zhhh0591/clawd-lcd-enclosure/docs/sheet2.png

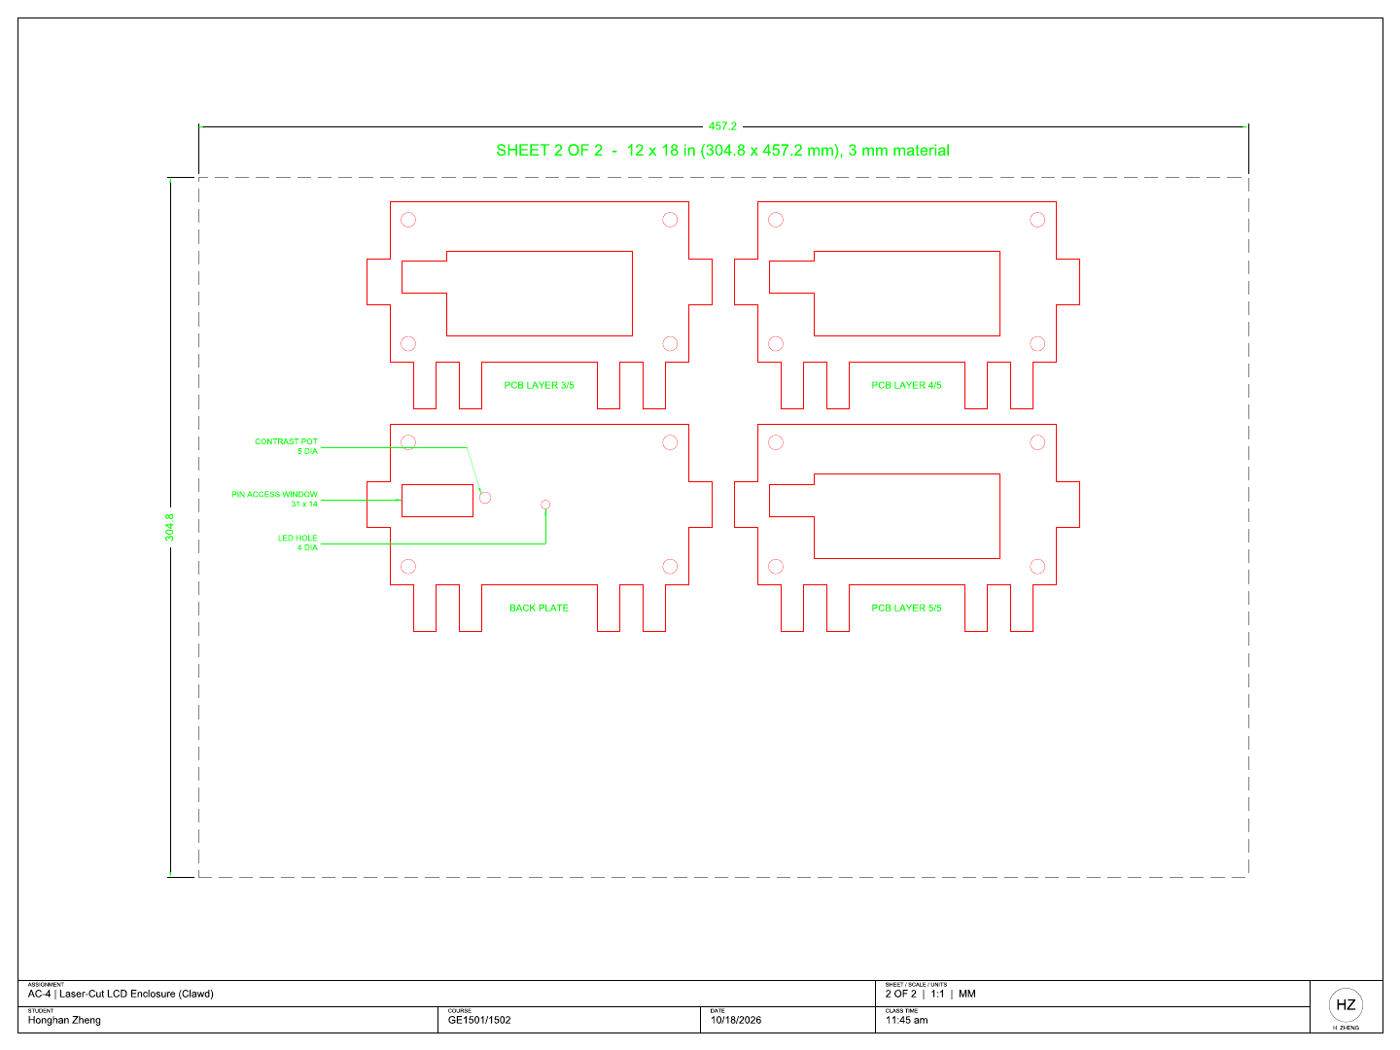
docs/sheet2.png
