zhhh0591/clawd-lcd-enclosure/FYELIC/Zheng_AC4_CUT_12x12.dxf

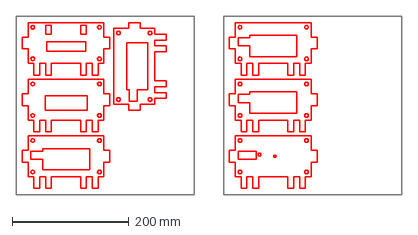
[picture p5: CAD file, 2026-10-19]
FYELIC/Zheng_AC4_CUT_12x12.dxf
659.6 x 304.8 mm
