zhhh0591/clawd-lcd-enclosure/works/Zheng_AC4.dxf

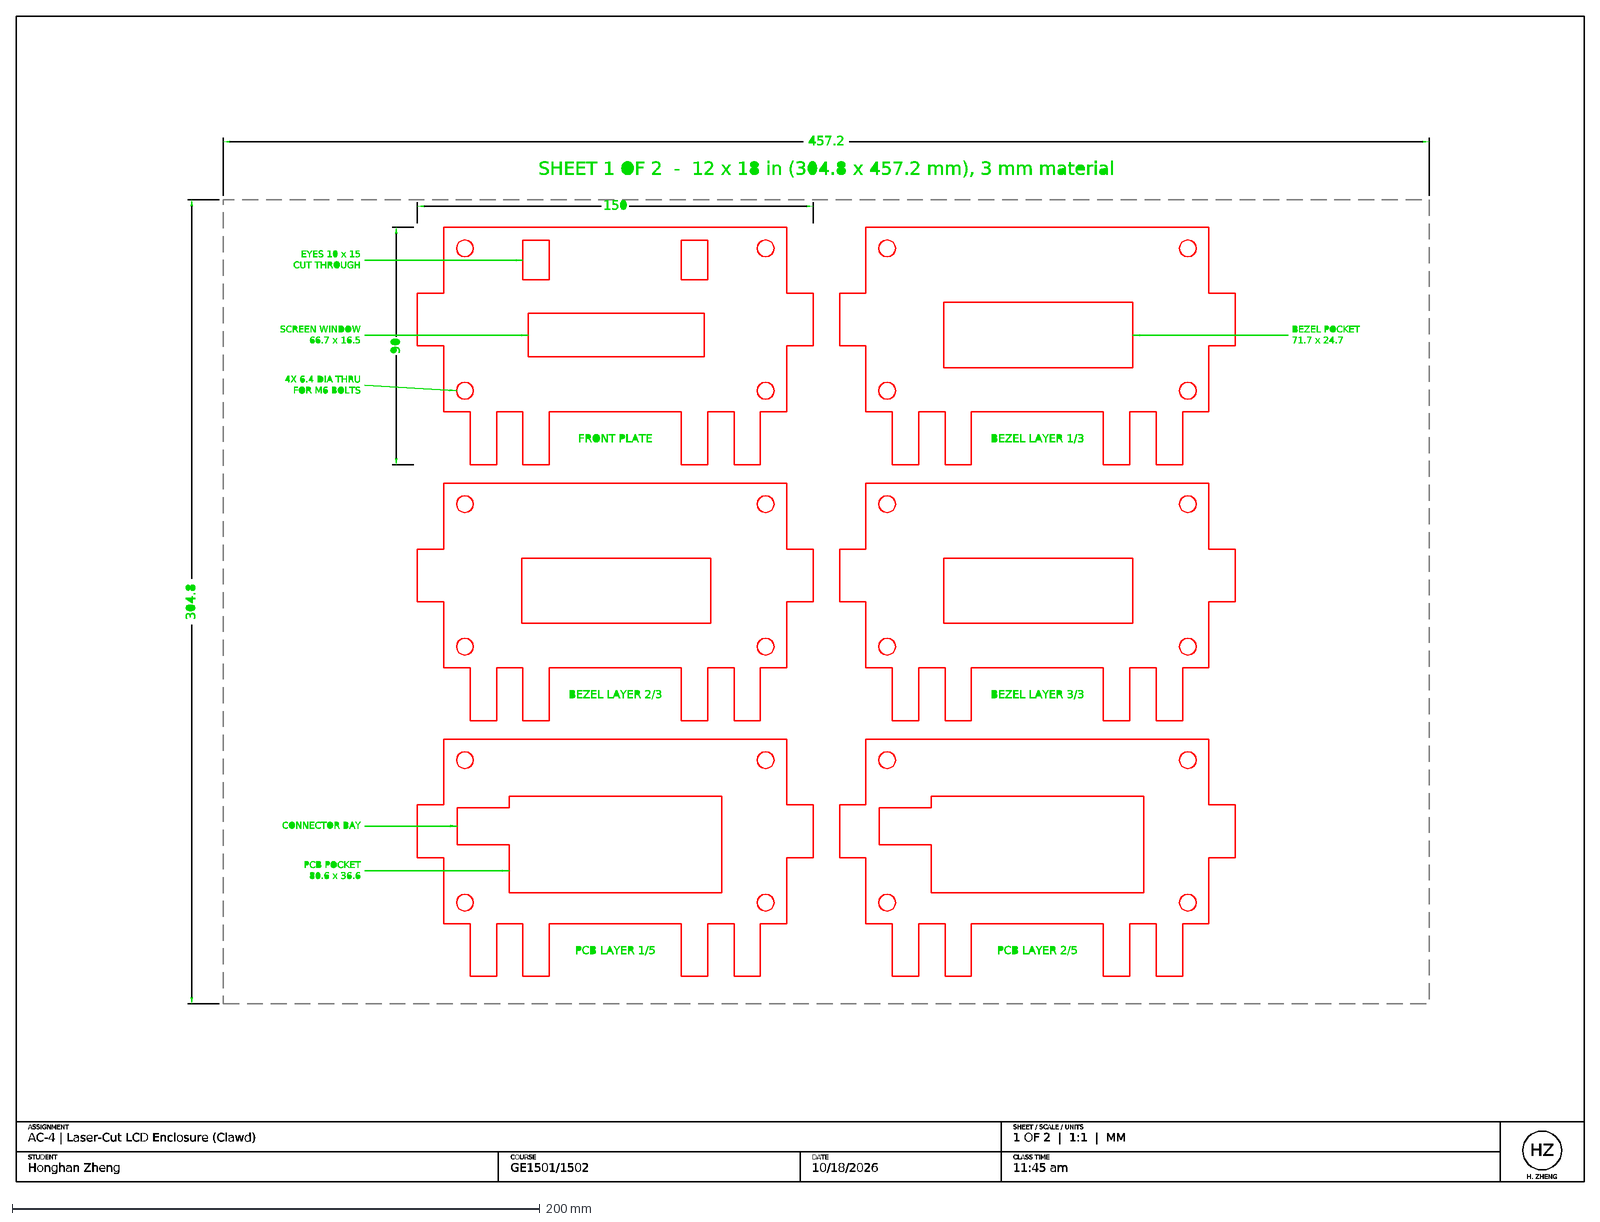
[picture p6: CAD file, 2026-10-18]
works/Zheng_AC4.dxf
ASSIGNMENT
AC-4 | Laser-Cut LCD Enclosure (Clawd)
SHEET / SCALE / UNITS
1 OF 2 | 1:1 | MM
STUDENT
Honghan Zheng
COURSE
GE1501/1502
DATE
10/18/2026
CLASS TIME
11:45 am
HZ
H. ZHENG
