zhhh0591/clawd-lcd-enclosure/FYELIC/Zheng_AC4_CUT_12x12_sheet2.dxf

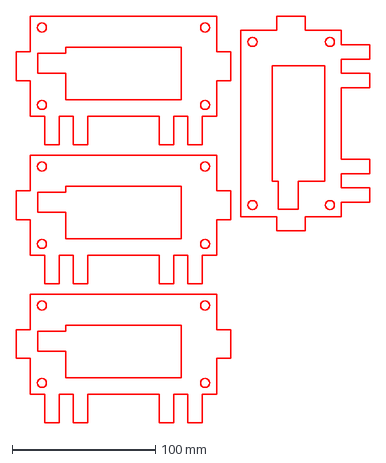
[picture p7: CAD file, 2026-10-19]
FYELIC/Zheng_AC4_CUT_12x12_sheet2.dxf
247.0 x 284.0 mm
