zhhh0591/clawd-lcd-enclosure/FYELIC/Zheng_AC4_CUT_sheet1.dxf

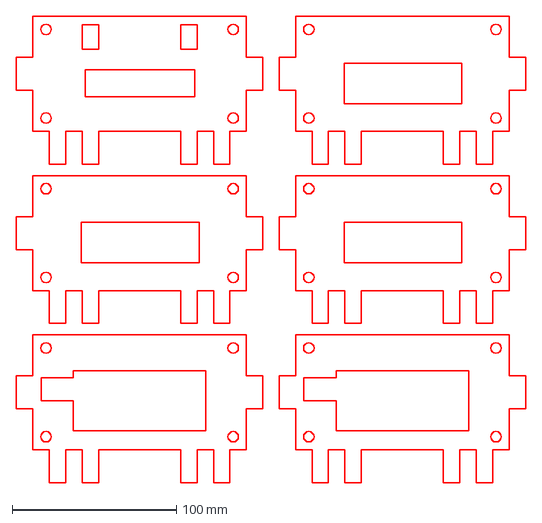
[picture p8: CAD file, 2026-10-18]
FYELIC/Zheng_AC4_CUT_sheet1.dxf
310.0 x 284.0 mm
