zhhh0591/clawd-lcd-enclosure/FYELIC/Zheng_AC4_CUT_sheet2.dxf

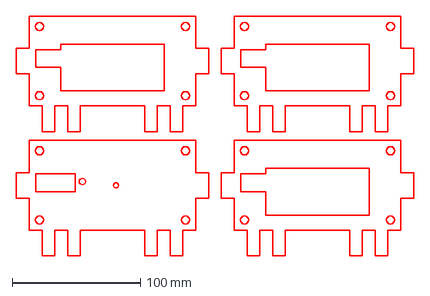
[picture p9: CAD file, 2026-10-18]
FYELIC/Zheng_AC4_CUT_sheet2.dxf
310.0 x 187.0 mm
