zhhh0591/clawd-lcd-enclosure/3D_print/M6_nut.stl

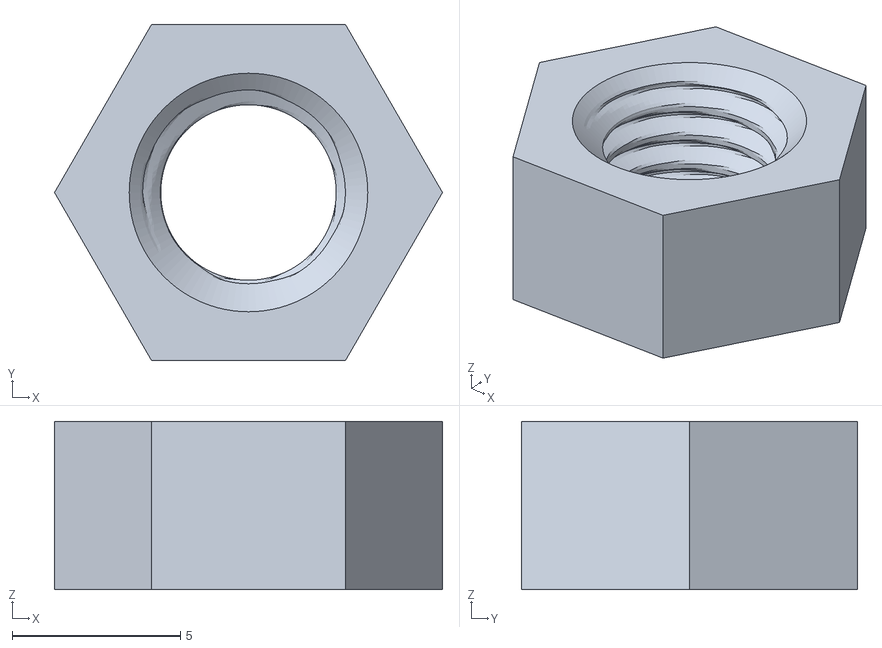
[picture p10: CAD file, 2026-10-18]
3D_print/M6_nut.stl
11.5 x 10.0 x 5.00
