zhhh0591/clawd-lcd-enclosure/3D_print/M6_bolts_and_nuts_x4.3mf

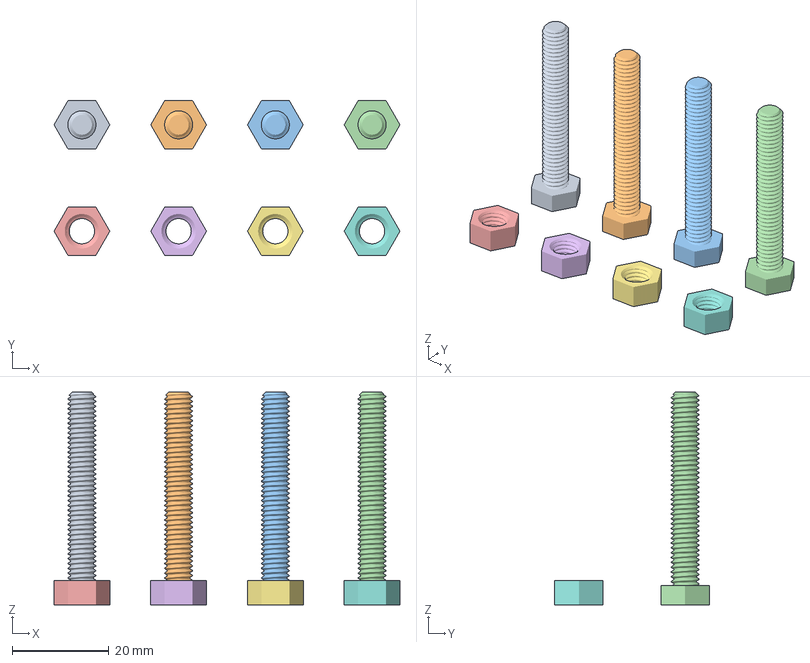
[picture p11: CAD file, 2026-10-18]
3D_print/M6_bolts_and_nuts_x4.3mf
71.5 x 32.0 x 44.0 mm
M6x40_bolt_1
M6x40_bolt_2
M6x40_bolt_3
M6x40_bolt_4
M6_nut_1
M6_nut_2
M6_nut_3
M6_nut_4
