zhhh0591/clawd-lcd-enclosure/3D_print/M6x40_bolt.stl

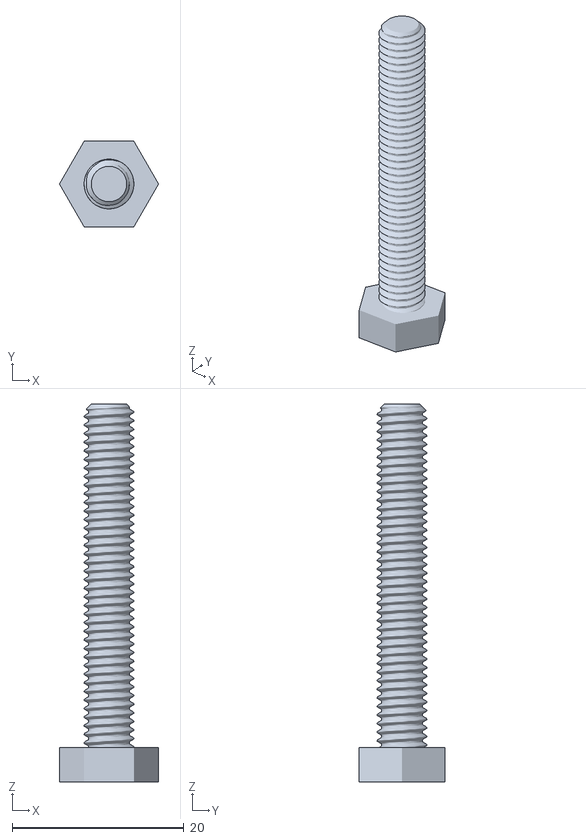
[picture p12: CAD file, 2026-10-18]
3D_print/M6x40_bolt.stl
11.5 x 10.0 x 44.0
