zhhh0591/clawd-lcd-enclosure/(list of files, cad)

Other CAD files:
LCD.dwg
3D_print/M6_bolts_and_nuts_x4.stl
works/Zheng_AC4.dwg
