zhhh0591/clawd-lcd-enclosure/FYELIC/Zheng_AC4_CUT_12x12.pdf

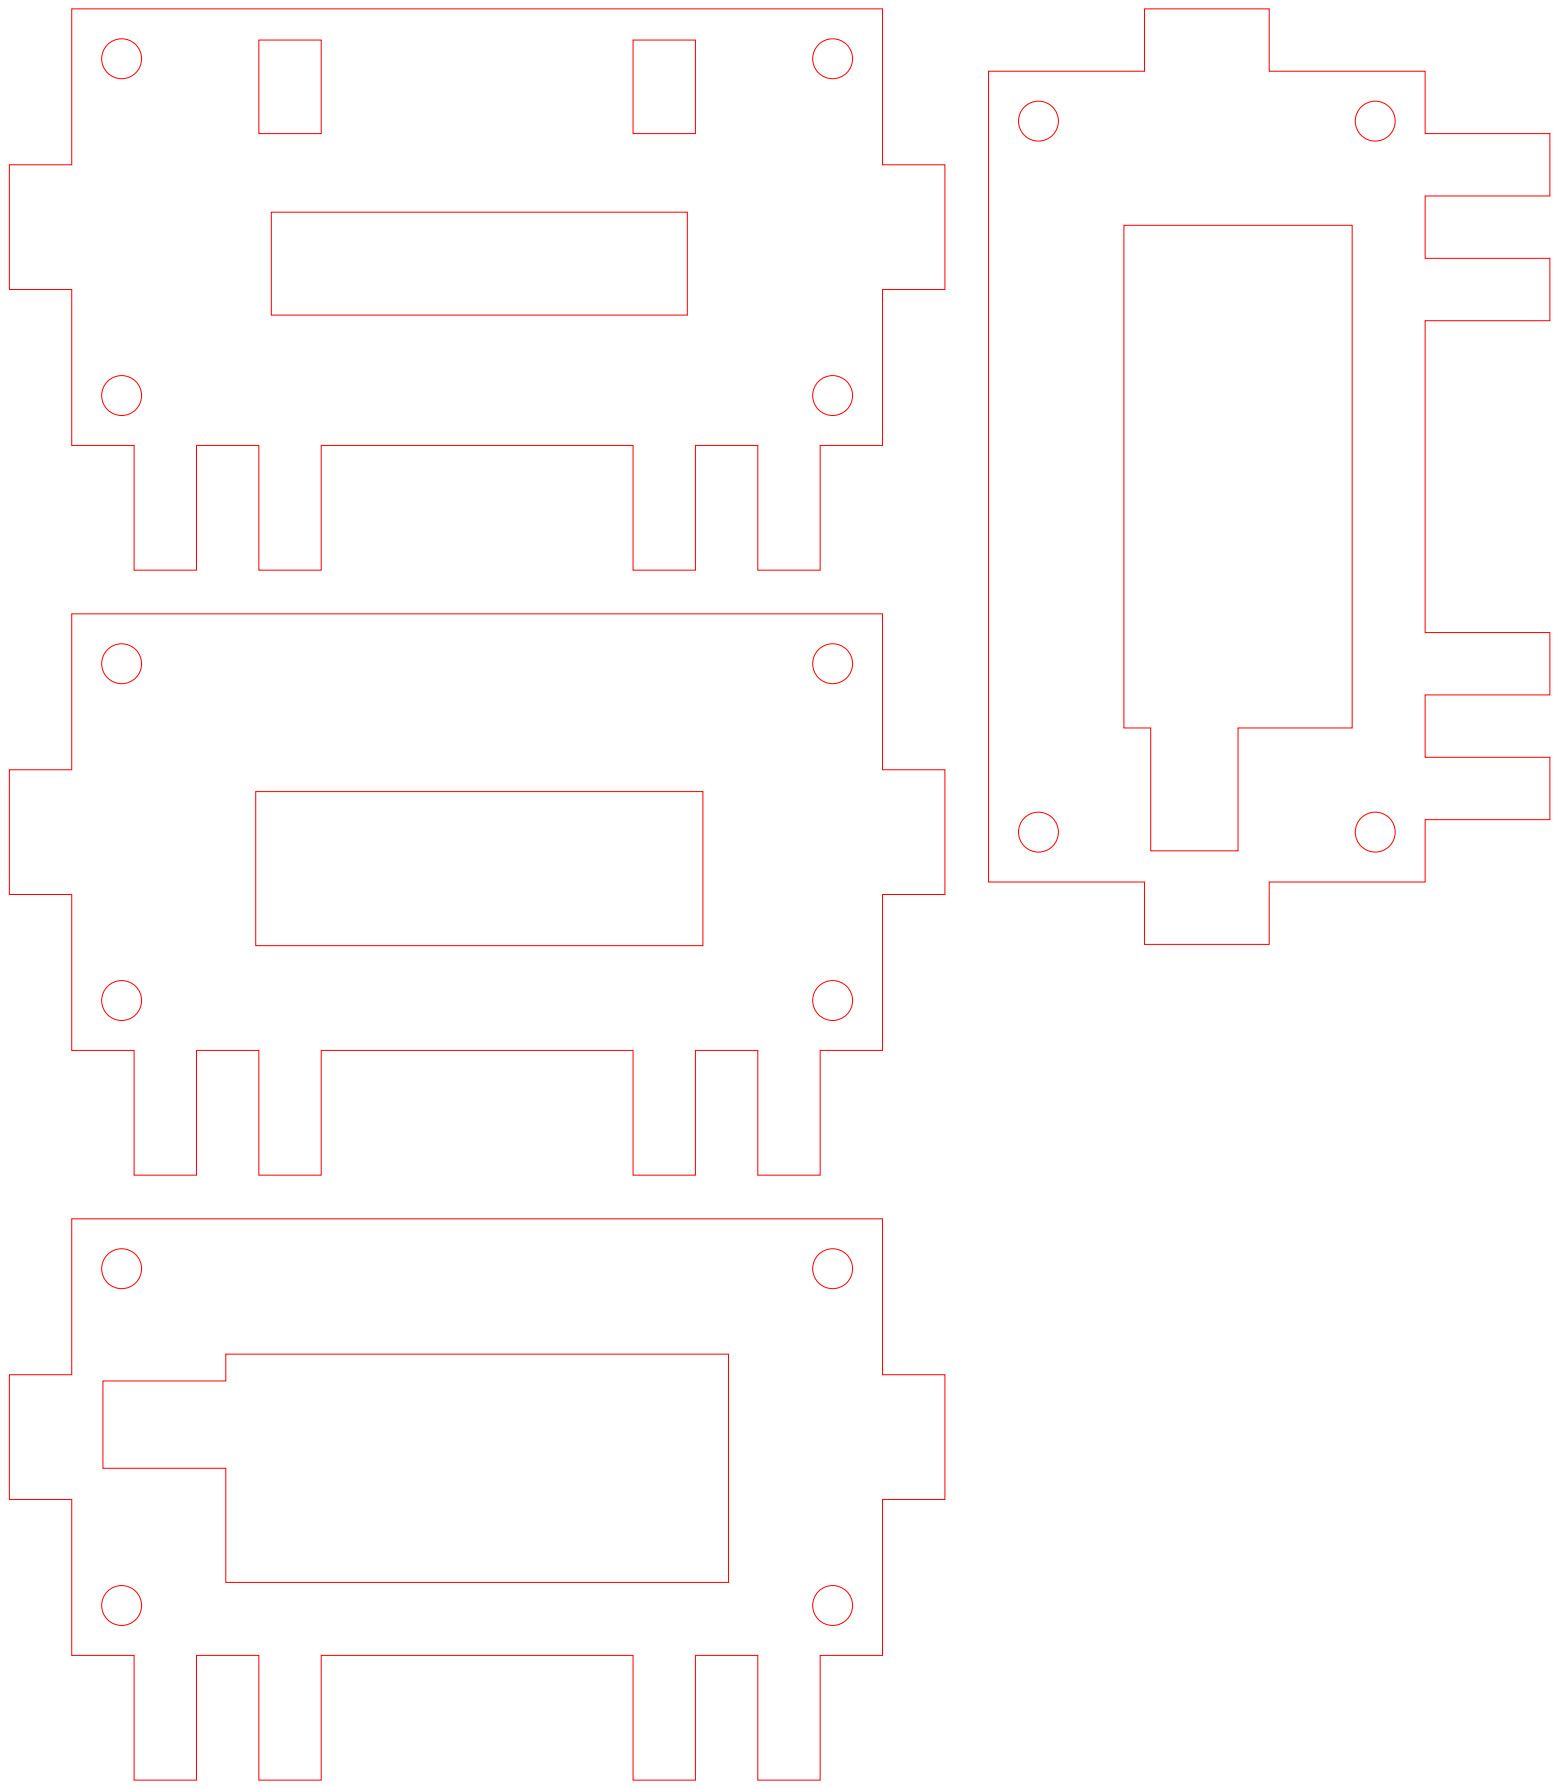
[picture p13: page 1]

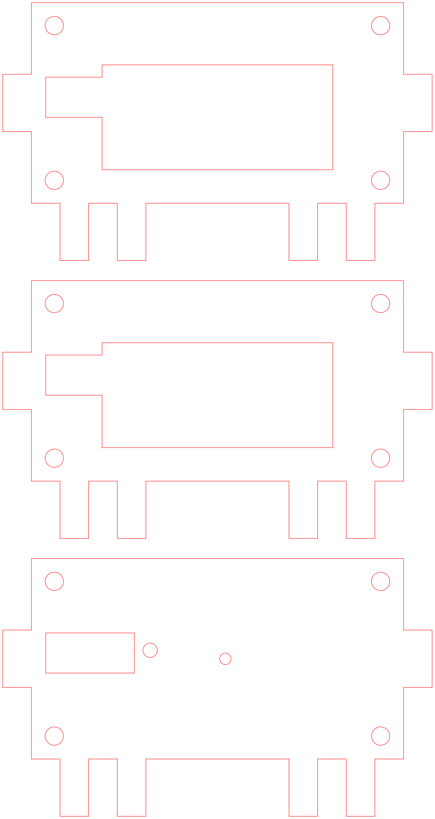
[picture p14: figure]
