zhhh0591/clawd-lcd-enclosure/works/Zheng_AC4.pdf

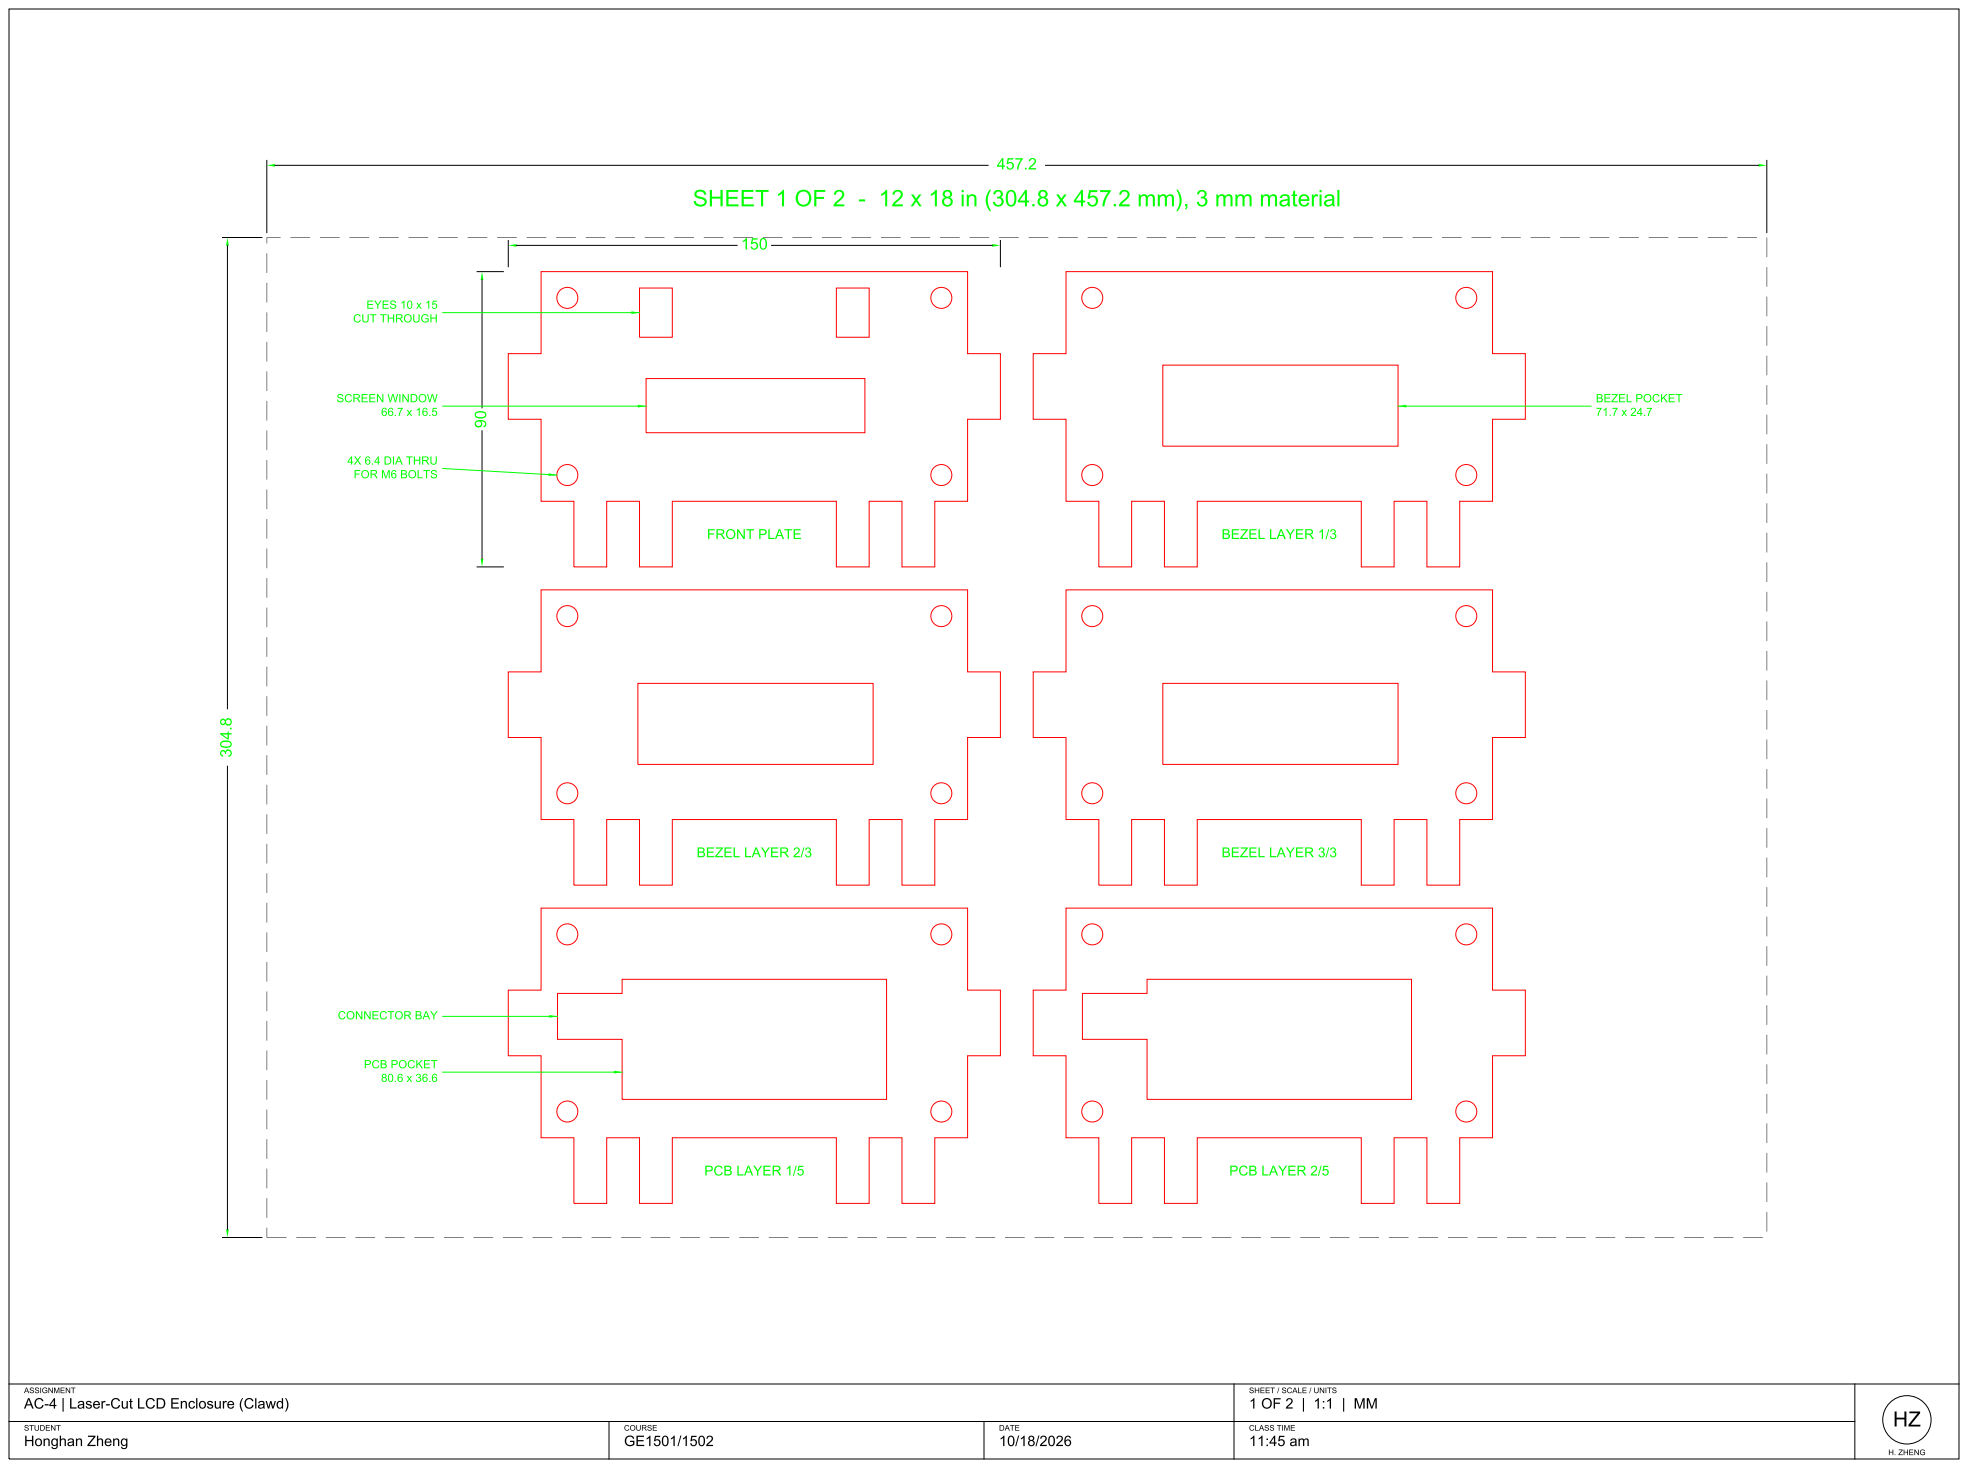
[picture p15: page 1]

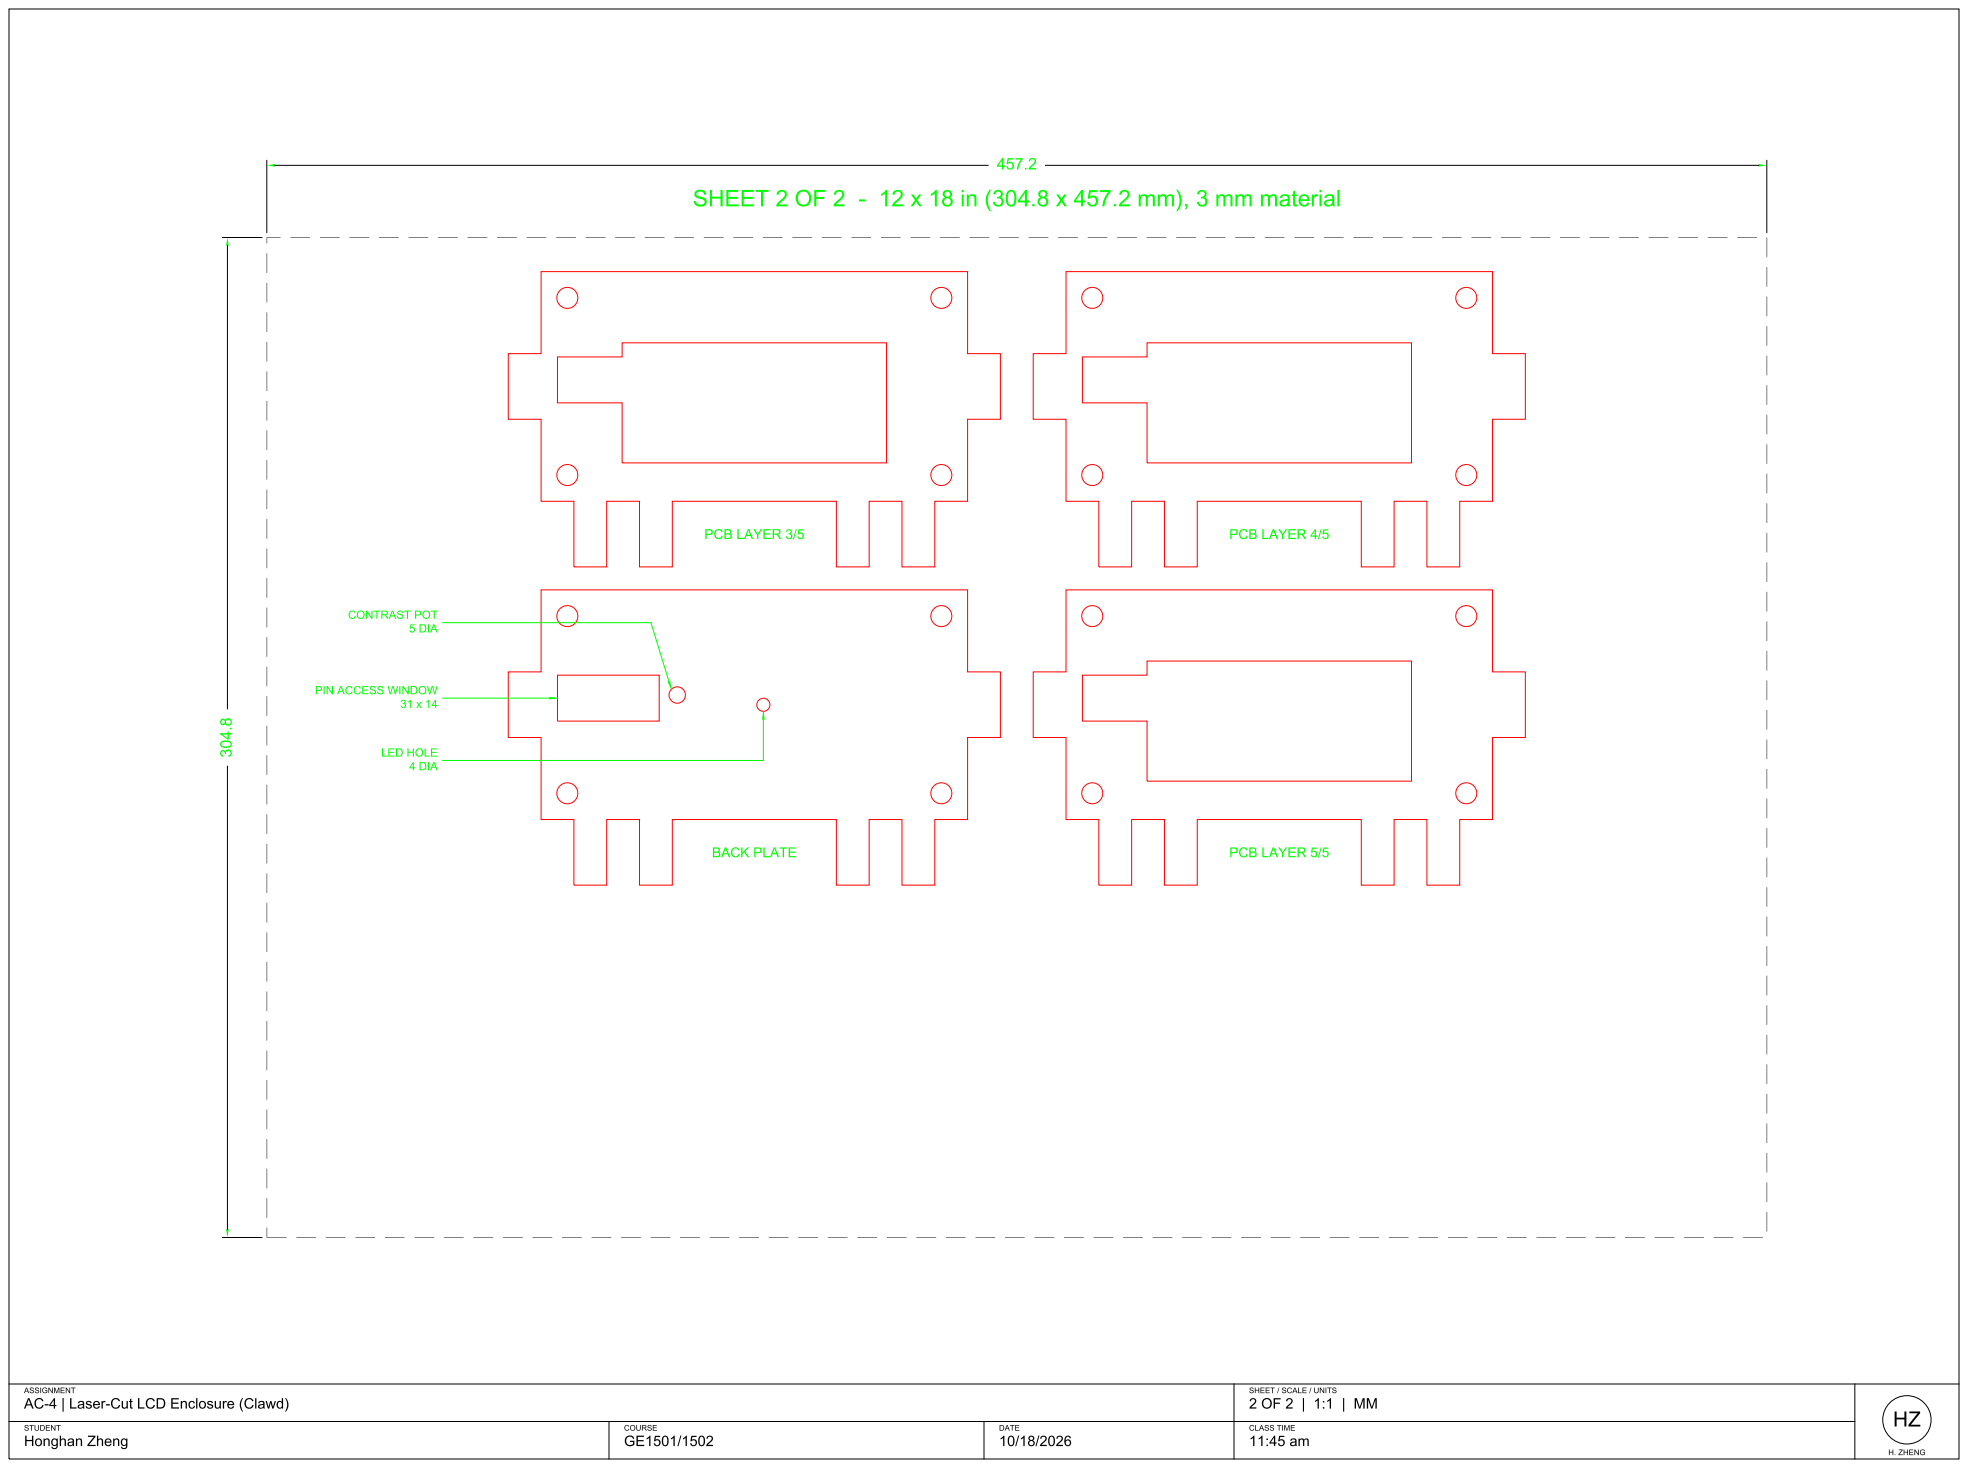
[picture p16: page 2]
