zhhh0591/clawd-lcd-enclosure/(commit log)

2026-10-18 Add course-provided LCD reference drawing
    [LCD.dwg]
2026-10-18 Add Arduino build config for the display sketch
2026-10-18 Add laser-cut layer drawing (DXF)
    [Zheng_AC4.dxf]
2026-10-18 Add AutoCAD drawing with M6 bolt holes (DWG)
    [Zheng_AC4.dwg]
2026-10-18 Add cut-only PDF for the FYELIC laser cutter
2026-10-18 Add cut-only DXF for sheet 1 (front, bezel and PCB layers)
    [Zheng_AC4_CUT_sheet1.dxf]
2026-10-18 Add cut-only DXF for sheet 2 (PCB layers and back plate)
    [Zheng_AC4_CUT_sheet2.dxf]
2026-10-18 Add printable M6x40 bolt
    [M6x40_bolt.stl]
2026-10-18 Add printable M6 nut
    [M6_nut.stl]
2026-10-18 Add print plate with 4 bolts and 4 nuts (3MF)
    [M6_bolts_and_nuts_x4.3mf]
2026-10-18 Add print plate as a single STL
    [M6_bolts_and_nuts_x4.stl]
2026-10-18 Add sliced print file for Prusa MK4 (0.4 nozzle, PLA)
2026-10-19 Re-nest FYELIC cut files for 12 x 12 in sheets
    [Zheng_AC4_CUT_12x12_sheet1.dxf, Zheng_AC4_CUT_12x12_sheet2.dxf, Zheng_AC4_CUT_12x12_sheet3.dxf]
2026-10-19 Update README for the 12 x 12 in cut files
2026-10-19 Update README for the merged cut DXF
2026-10-19 Cut 7 layers instead of 10 for the 12 mm thick LCD
    [Zheng_AC4_CUT_12x12.dxf]
2026-10-19 Update thickness check and assembly notes for 7 layers
